FdeSchae/RODI/HardwareDesign/POM box.JPG

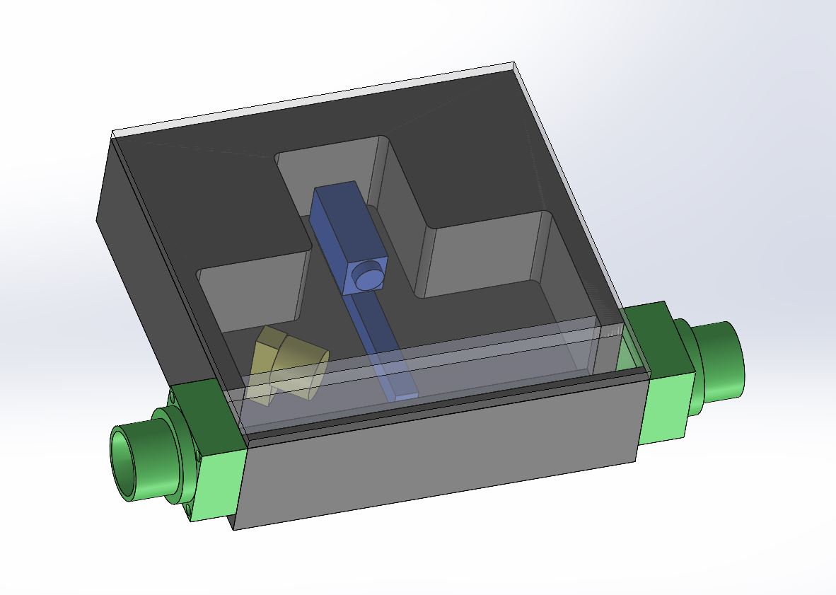
HardwareDesign/POM box.JPG
