FdeSchae/RODI/README.md

The Riverine Organism Drift Imager (RODI)

This repository was archived on zenodo:
