FdeSchae/RODI/HardwareDesign/POB Box chnitt 2.JPG

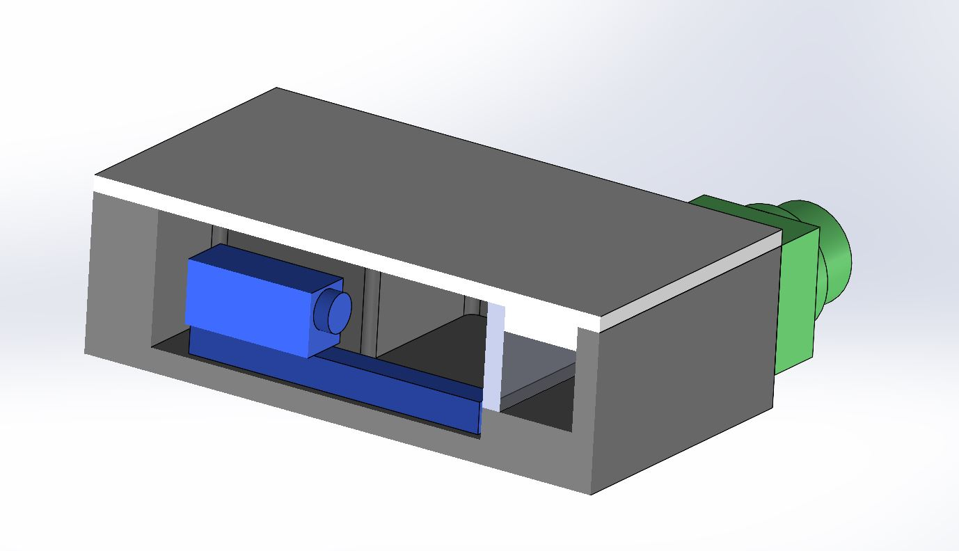
HardwareDesign/POB Box chnitt 2.JPG
