FdeSchae/RODI/HardwareDesign/POM BOX _ ohne Deckel und Kamera.JPG

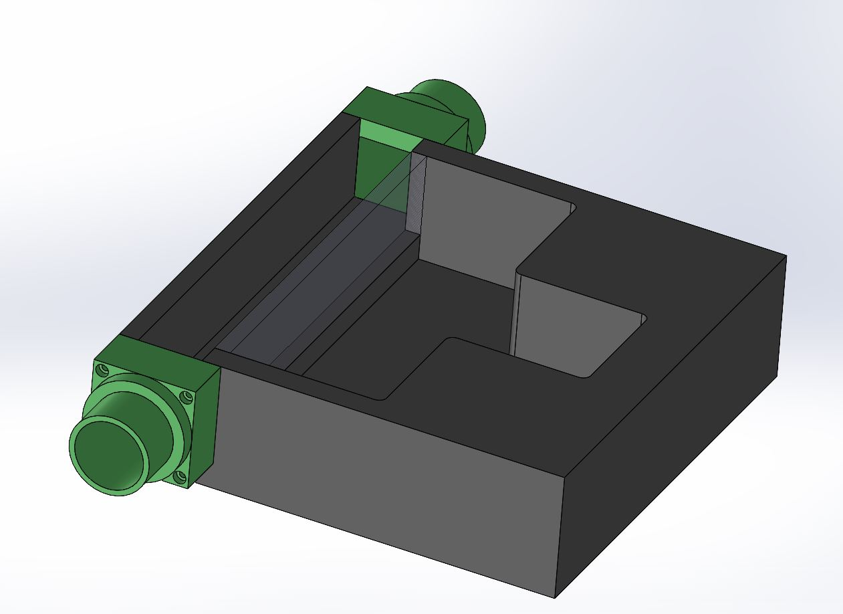
HardwareDesign/POM BOX _ ohne Deckel und Kamera.JPG
