FdeSchae/RODI/HardwareDesign/POM box _schnitt.JPG

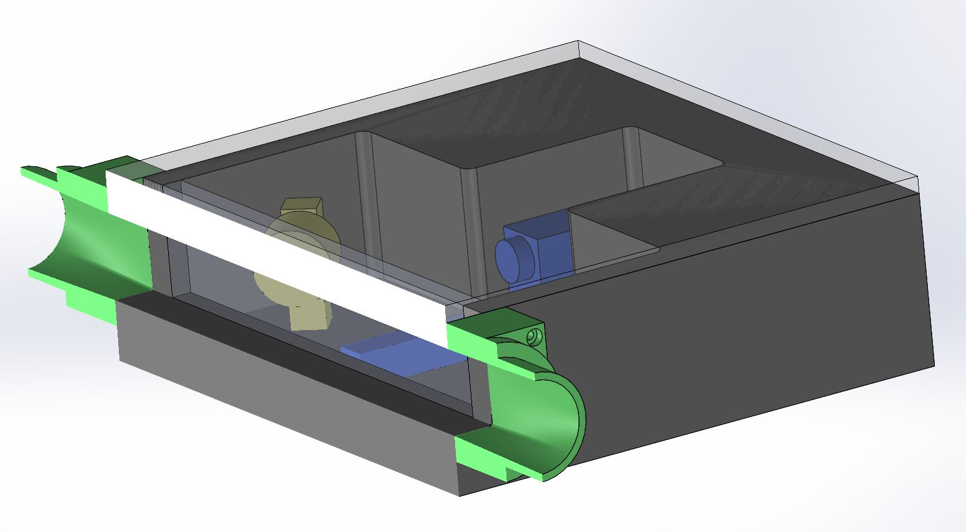
HardwareDesign/POM box _schnitt.JPG
