FdeSchae/RODI/HardwareDesign/licht.SLDPRT

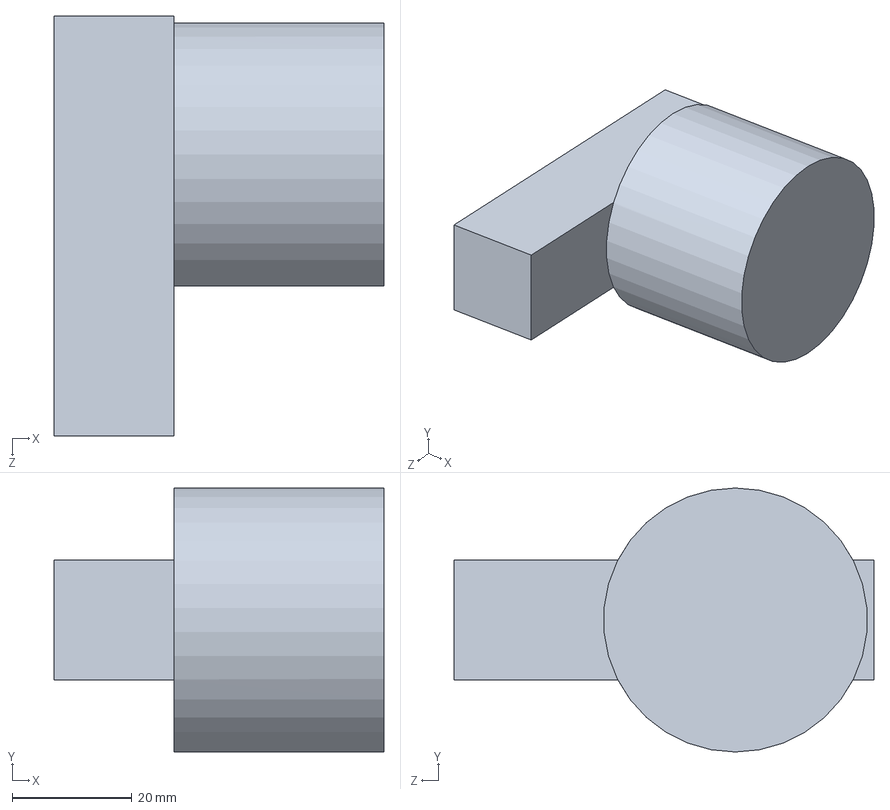
[picture p6: CAD file, 2023-03-20]
HardwareDesign/licht.SLDPRT
55.0 x 44.0 x 70.0 mm
