FdeSchae/RODI/HardwareDesign/FLIR cam.SLDPRT

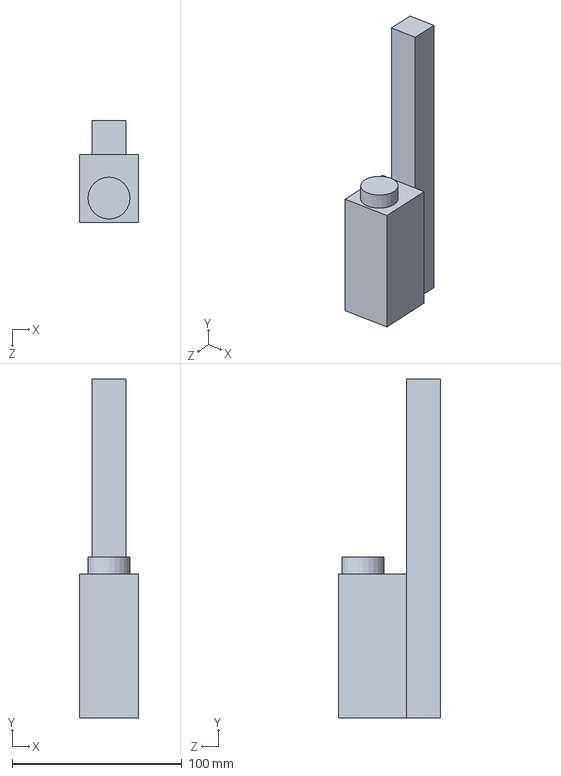
[picture p7: CAD file, 2023-03-20]
HardwareDesign/FLIR cam.SLDPRT
35.0 x 200.0 x 60.0 mm
