FdeSchae/RODI/HardwareDesign/Adapter.STEP

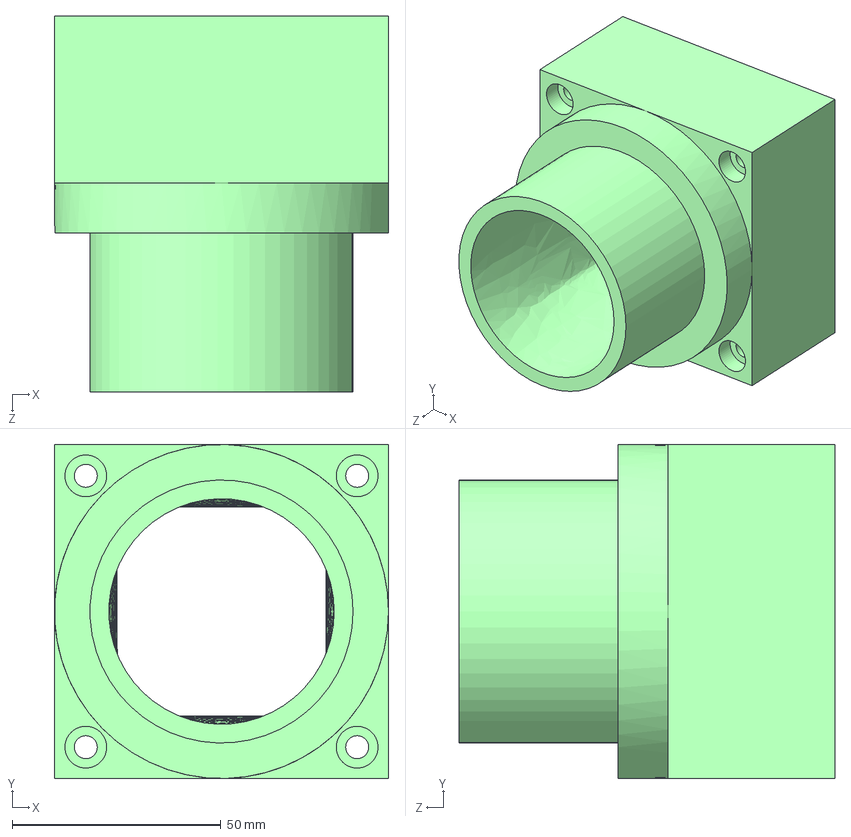
[picture p8: CAD file, 2023-03-20]
HardwareDesign/Adapter.STEP
80.0 x 80.0 x 90.0 mm
