FdeSchae/RODI/HardwareDesign/POM_HydroElement.SLDPRT

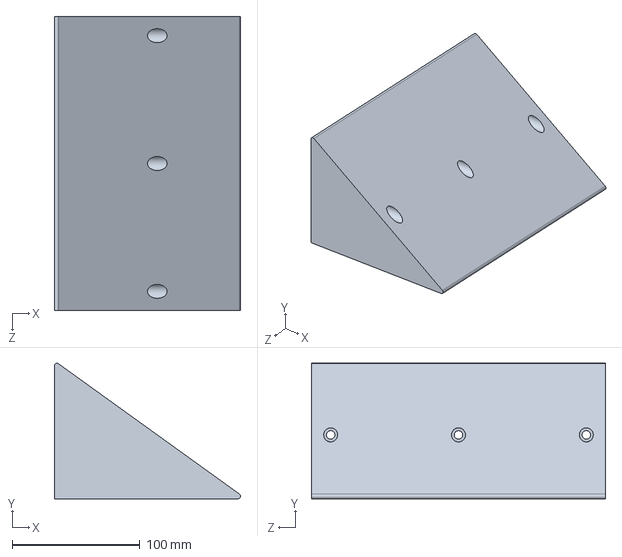
[picture p9: CAD file, 2023-03-20]
HardwareDesign/POM_HydroElement.SLDPRT
145.8 x 106.1 x 230.0 mm
