FdeSchae/RODI/HardwareDesign/POM_FlowTubeCeiling.SLDPRT

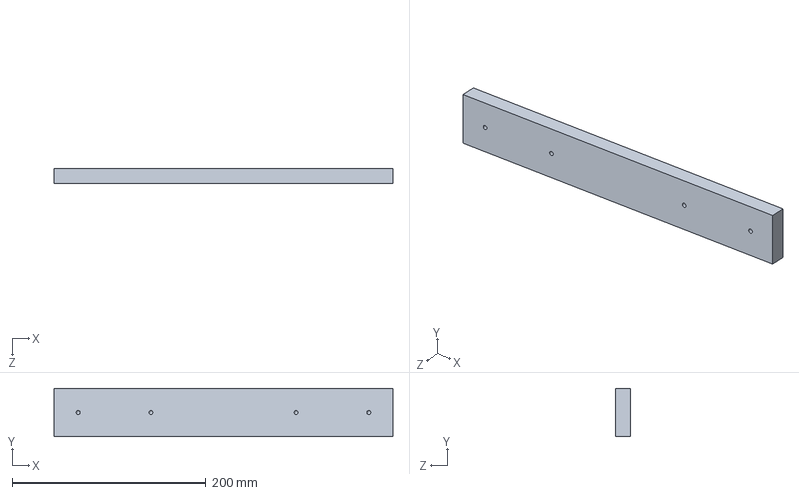
[picture p10: CAD file, 2023-03-20]
HardwareDesign/POM_FlowTubeCeiling.SLDPRT
350.0 x 50.0 x 15.0 mm
