FdeSchae/RODI/HardwareDesign/Polycarbonate_Window.SLDPRT

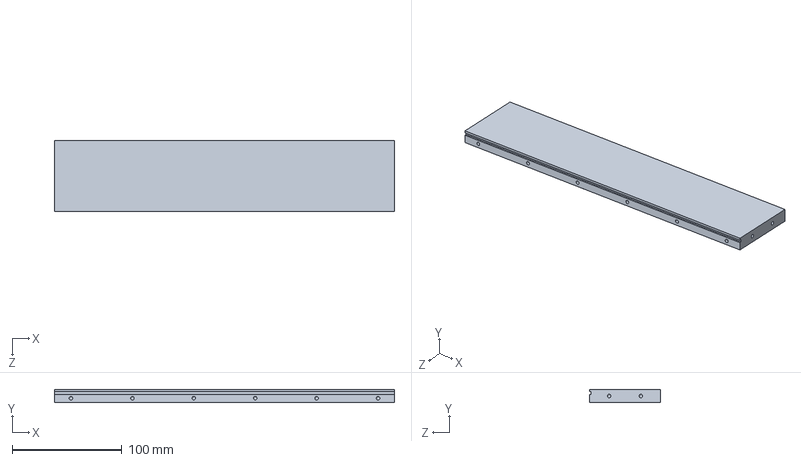
[picture p12: CAD file, 2023-03-20]
HardwareDesign/Polycarbonate_Window.SLDPRT
310.0 x 12.0 x 65.0 mm
