FdeSchae/RODI/(list of files, cad)

Other CAD files:
HardwareDesign/Adapter.SLDPRT
HardwareDesign/Adapter.STL
HardwareDesign/AluminumLid.SLDDRW
HardwareDesign/AluminumLid.SLDPRT
HardwareDesign/POM_Box.SLDDRW
HardwareDesign/POM_Box.SLDPRT
HardwareDesign/POM_Box.STL
HardwareDesign/POM_FlowTubeCeiling.SLDDRW
HardwareDesign/POM_HydroElement.SLDDRW
HardwareDesign/Polycarbonate_Window.SLDDRW
HardwareDesign/RODI Case.SLDASM
HardwareDesign/RODI case.STL
