FdeSchae/RODI/HardwareDesign/DriftNet.pdf

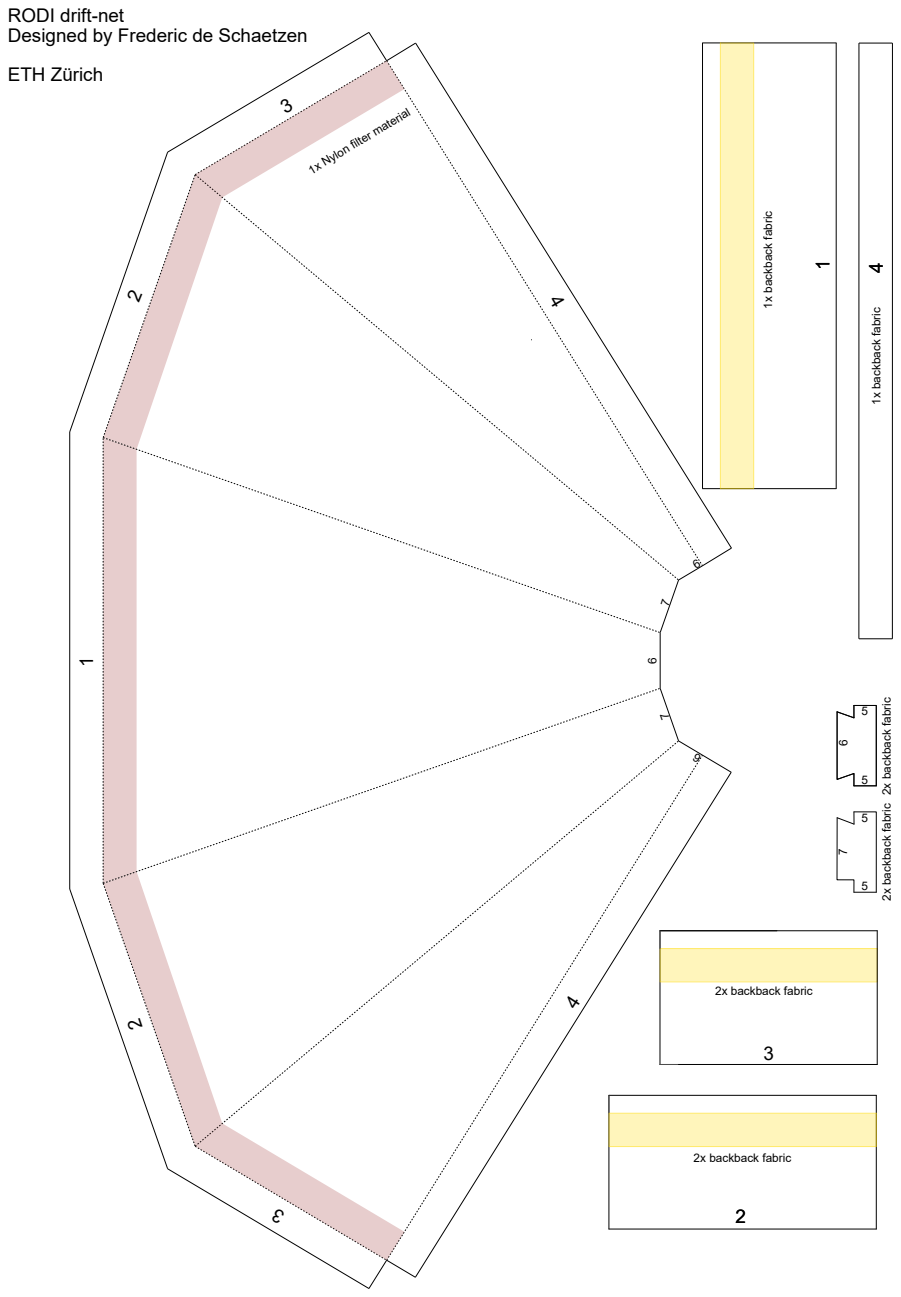
[picture p15: page 1]
1x backback fabric; 2x backback fabric; ETH Zürich

RODI drift-net
Designed by Frederic de Schaetzen

1x Nylon filter material

2x backback fabric
