FdeSchae/RODI/HardwareDesign/Polycarbonate_Window.pdf

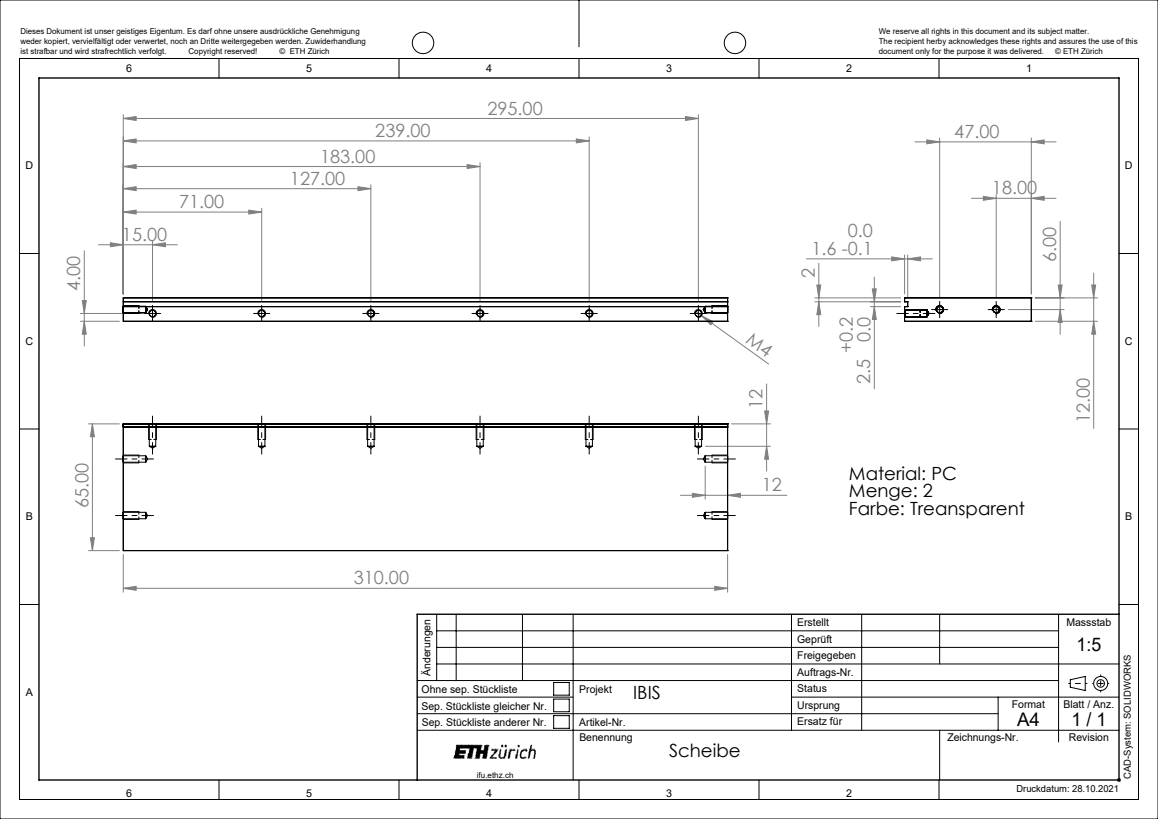
[picture p16: page 1]
Material: PC Menge: 2 Farbe: Treansparent; Druckdatum: 28.10.2021; ist strafbar und wird strafrechtlich verfolgt.; Copyright reserved!; © ETH Zürich; Ersatz für; Blatt / Anz. 1 / 1

Dieses Dokument ist unser geistiges Eigentum. Es darf ohne unsere ausdrückliche Genehmigung
weder kopiert, vervielfältigt oder verwertet, noch an Dritte weitergegeben werden. Zuwiderhandlung

We reserve all rights in this document and its subject matter.
The recipient herby acknowledges these rights and assures the use of this
document only for the purpose it was delivered. © ETH Zürich

Erstellt
Geprüft

CAD-System: SOLIDWORKS

Ohne sep. Stückliste
Sep. Stückliste gleicher Nr.
Sep. Stückliste anderer Nr.

ifu.ethz.ch
