FdeSchae/RODI/(commit log)

2022-04-29 Add project files.
    [myconfig.txt]
2022-05-11 frameCheck method
    Checking if there is an object in the image - bool format
    Location of the center of the object - Point format
    There are two methods in the code with the same name because I used a method overload in case the background image is not available
    Addition: commented method ConvertToCVmat to transform the captured buffer into an OpenCV Mat
2022-05-11 check frames
    frameCheck method produces two results:
    1. the answer whether there is an object visible in the image - bool
    2. location of the center of the object - Point
    Additionally, I have included a commented method that transforms the captured buffer into an OpenCV Mat
    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
2022-05-11 Update and rename Source.cpp to frameCheck.cpp
